HoodPaul/amiga-72pin-fpm-simm/README.md

# Amiga 72-pin FPM SIMM

A common PCB for **4 MB single-sided** and **8 MB double-sided** 5 V FPM SIMMs, developed for Amiga 4000 motherboard memory configurations. Current revision: **A7**.

The project began with a wish to make RAM that visually matches Re-Amiga systems: **black PCB, white silkscreen and gold contacts and exposed pads**. It is a collaboration between **Paul of UK Computing Limited**, **Jon of JMC Electronics** and **AI assistance through Codex**.

**FIRST SUCCESSFUL HARDWARE TEST: 7 November 2026.** Five custom Rev A7 SIMMs installed in an Amiga 4000D were recognised by Kickstart Memory Scan as **18.00 MB total (2.00 MB Chip RAM + 16.00 MB Fast RAM)**. The Chip RAM socket contained one physically **8 MB double-sided** module, recognised as **2 MB Chip RAM**; the four Fast RAM sockets contained four **4 MB front-only** modules. Paul reports the machine alive and working. This establishes initial detection and operation, not a completed extended memory, refresh, retention or graphics/DMA diagnostic. See the [first hardware test report](docs/2026-11-07-FIRST-A4000D-HARDWARE-TEST.md).

**Previous manufacturing milestone, 24 October 2026:** All 15 JLCPCB PCBs were reported manufactured and in transit. Five have since been assembled and demonstrated in the host. Exact receipt date, full shipment count and finished-board measurements have not been recorded. See the [manufacturing record](docs/FABRICATION-OPTIONS.md) and [production-file review](docs/JLCPCB-PRODUCTION-REVIEW.md).

For another engineer or AI picking up the project, start with [AGENTS.md](AGENTS.md), the [current AI handover](docs/AI-HANDOVER.md) and the [documentation index](docs/README.md).

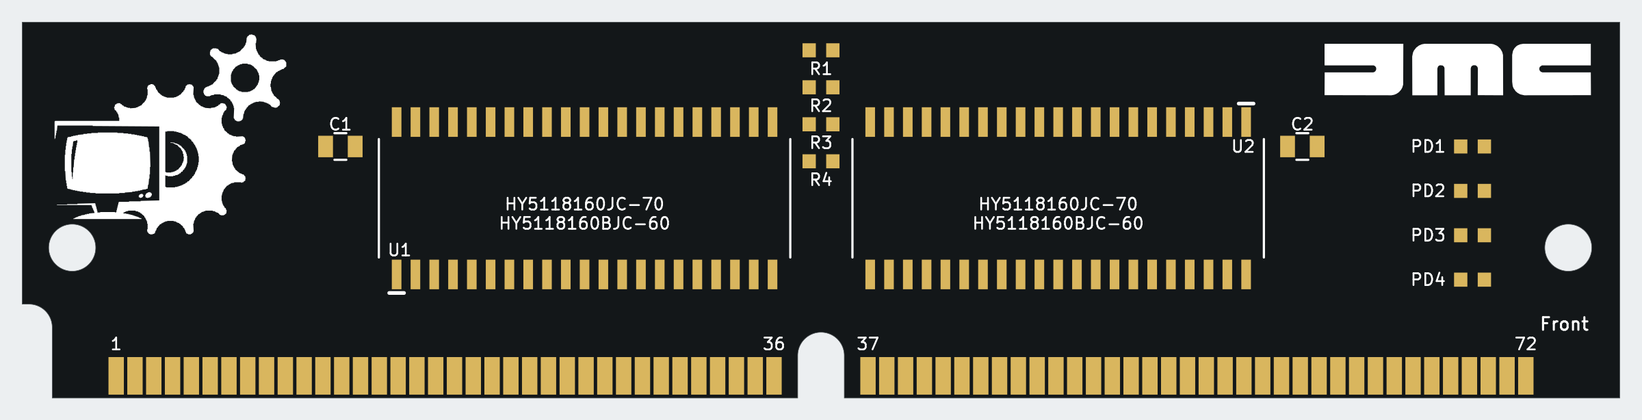
[picture p1: previews/appearance-front.png]
Front appearance

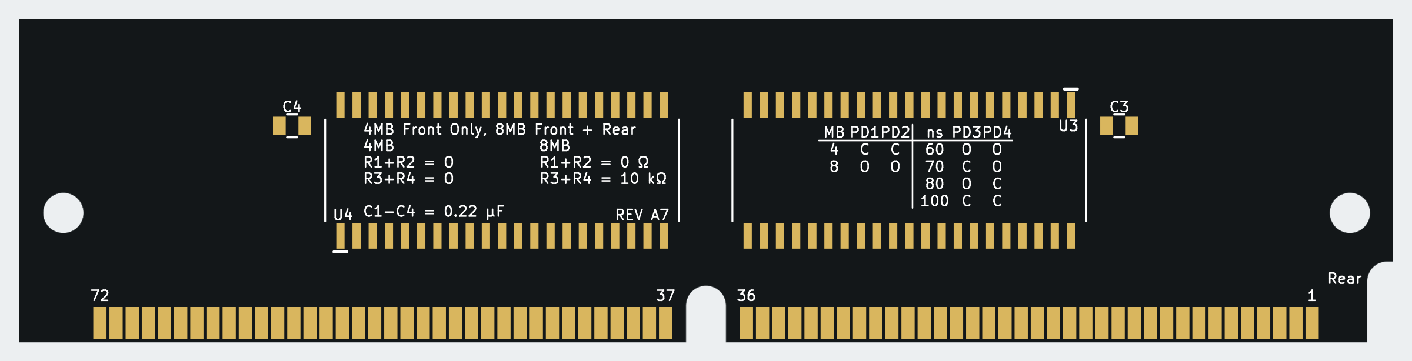
[picture p2: previews/appearance-rear.png]
Rear appearance


These are unpopulated CAD appearance previews: black solder mask, white silkscreen and gold exposed pads. Actual colours and contact plating are fabrication choices.

## PCB and files

Open [HY8M-SIMM.kicad_pro](HY8M-SIMM.kicad_pro) with **KiCad 10.0 or newer**. Project-local symbols and footprints are included.

| Property | Current design |
|---|---|
| Connector | 72-pin SIMM, 32-bit non-parity |
| Outline | 107.95 × 25.4 mm |
| Finished thickness | 1.2 mm ordered; measure finished boards and verify socket fit |
| Copper layers | **Four** |
| F.Cu | Front signals and pads |
| In1.Cu | GND plane |
| In2.Cu | Signals and +5 V copper fill |
| B.Cu | Rear signals and pads |
| Minimum signal track / nominal clearance | 0.20 / 0.20 mm |
| Through vias | 0.60 mm copper diameter / 0.30 mm drill |

In2.Cu is a mixed signal/supply layer. The design does not have separate GND and power planes on this four-layer PCB.

## 70 ns assembly options

Both builds use **HY5118160JC-70** DRAMs and the same PCB. DNP means do not populate.

| Build | DRAM population | Capacitors fitted | R1/R2 | R3/R4 | PD links fitted |
|---|---|---|---|---|---|
| [4 MB / 70 ns](variants/4MB-70ns/BOM.csv) | U1/U2, front only | C1/C2 | DNP | DNP | PD1, PD2, PD3 |
| [8 MB / 70 ns](variants/8MB-70ns/BOM.csv) | U1–U4, both faces | C1–C4 | 0 Ω each | 10 kΩ each | PD3 |

Capacitors are **220 nF (0.22 µF), 0805, X7R, 16 V or higher**. Use new capacitors. Links and pull-ups use 0603 pads. PD4 remains open in both builds.

Separate [60 ns variants](assembly-options.csv) are retained for the verified **HY5118160BJC-60** part. Use the chosen variant's BOM and DNP-marked schematic. Fitting different PD links cannot make a 70 ns chip operate as a 60 ns part.

A true 4 MB single-sided build omits U3/U4, C3/C4 and R1–R4. Disabling the rear rank of a physically double-sided board does not make it a single-sided module for socket clearance.

## Intended Amiga configurations

| Purpose | Intended population |
|---|---|
| 2 MB Chip RAM | One fully populated 8 MB module; intended to use 2 MB and leave 6 MB unaddressed |
| 16 MB Fast RAM | Two 8 MB modules in Fast slots 1 and 3 |
| 16 MB Fast RAM | Four front-only 4 MB modules in Fast slots 1–4 |

Fast-slot numbering excludes the separate Chip RAM socket. **The 8 MB physical Chip module used as 2 MB Chip RAM and four 4 MB Fast modules have now been recognised together on an A4000D (7 November 2026)**. The alternative two-8 MB Fast RAM configuration remains untested. The Chip RAM socket does not gain 8 MB of addressable Chip RAM. See [hardware test evidence](docs/2026-11-07-FIRST-A4000D-HARDWARE-TEST.md) and [compatibility research](docs/compatibility-research.md).

## Donor chips

The Hyundai HY5118160 devices were chosen for their relatively low SOJ package profile and the availability of suitable donor SIMMs on online marketplaces during project planning. This made them a practical starting point for the matching modules while keeping one chip family across the 4 MB and 8 MB builds.

Obtain readable photographs of **every fitted chip on both faces** before buying a donor. The specified 70 ns device is **HY5118160JC-70**: 5 V, 1M×16, FPM, 42-pin 400 mil SOJ, 1K refresh. The separately verified 60 ns alternative is **HY5118160BJC-60**.

An “8 MB / 2M×32 / 72-pin” listing or bare PCB number does not identify its chips. **HY5118164 is EDO**, and **HY5116160B has a different refresh organisation**; neither is the specified donor. Confirm the complete marking and datasheet rather than relying on similar part numbers.

### Most likely alternative DRAMs (not yet tested)

The **LG/GoldStar GM71C18160CJ-7 (70 ns)**, **GM71C18160CJ-6 (60 ns)**, **Samsung KM416C1200AJ-7 (70 ns)** and **KM416C1200AJ-6 (60 ns)** are promising **5 V, 1M × 16, FPM, 1K-refresh, 42-pin SOJ** candidates. **All four remain untested on Rev A7**, with no proven donor-board or Amiga hardware result. Confirm the exact part's pinout, package, refresh and timing before using it. See the [LG/Samsung alternative comparison and source links](docs/compatibility-research.md#high-confidence-lggoldstar-and-samsung-alternatives-untested-9-november-2026).

Test the intact donor before desoldering and record orientation/pin 1. One healthy four-chip donor can supply one 8 MB board or two 4 MB boards, assuming all devices survive removal. This project does not certify donor authenticity, seller stock or recovered-chip health.

## Prototype fabrication and remaining checks

- **Current order:** four layers, 1.2 mm nominal, 1 oz copper on all layers, black mask, white silkscreen, **ENIG 2 microinch**, ink-plugged vias, **no bevel**, deburring, no edge plating and no manufacturer mark. See the [ordering settings and screenshots](docs/FABRICATION-OPTIONS.md).
- **Contacts:** the native pad setback is **0.2286 mm**; CAM copper compensation leaves approximately **0.221 mm**. The original 144 findings against the generic 0.50 mm edge rule remain documented. The reviewed CAM preserves all contacts and functional connections; this is specific to this prototype package, not blanket approval for other manufacturers or bevel processes.
- **Finish and fit:** the selected ENIG prototype finish differs from the earlier selective hard-gold proposal. Hard gold offers better wear resistance for repeated insertion. Measure the finished connector thickness and inspect edge quality, SOJ fit and socket/case clearance before use. Substantial hand bevelling could cut into the plated contacts.

The retaining holes are closed circular Edge.Cuts profiles in the source; JLCPCB converted these to **3.18 mm finished non-plated holes** with compensated 3.25 mm tools. Use the [four-layer file map](docs/layer-file-map.txt) and read [fabrication notes](fabrication-review/READ-BEFORE-ORDERING.txt). The common paste layers include all footprints; assembly/stencil use must follow the chosen BOM.

## Checks and limitations

The saved design has **864 track segments, 195 vias and zero unconnected items**. The [exact copper comparison](docs/copper-comparison.txt) confirms unchanged routing, pads, component placements, outline and filled copper between A3–A6, the user-edited PCB and A7. The independent mapping review passes 321 assertions.

**144 contact-edge errors and 46 schematic-parity warnings remain documented.** Existing project settings ignore seven check types; no ERC report is included. Read [validation.txt](docs/validation.txt) and the [native DRC report](docs/drc-routed.json) for the scope and remaining findings. CAD checks do not establish timing, refresh, signal integrity or operation in an Amiga.

Run the portable preservation audit from the repository root:

```sh
python3 source/compare_copper.py
```

The current silkscreen preserves the manually edited layout, with UK Computing artwork on the front left and JMC on the front right. Rear assembly notes and PD tables sit beneath the rear chip bodies. Historical generator scripts can overwrite custom artwork; use the [development workflow](source/WORKFLOW.md).

## Project contents

| Path | Purpose |
|---|---|
| [BOM.csv](BOM.csv), [assembly-options.csv](assembly-options.csv) | Population comparison |
| [variants/](variants/) | Four assembly BOMs and DNP-marked schematics |
| [previews/](previews/) | Native layer plots, schematic and appearance views |
| [fabrication-review/](fabrication-review/) | Draft Gerbers, drills and fabrication notes |
| [docs/](docs/) | Pin map, research and validation reports |
| [source/](source/) | Artwork baseline, reference PCB and development/verification tools |
| [Assembly guide](docs/ASSEMBLY.md) | 70 ns parts, fitting and system quantities |
| [Component ordering](docs/COMPONENT-ORDERING.md) | DigiKey parts and quantities for either ten single-sided or ten double-sided modules, with spares |
| [Fabrication options](docs/FABRICATION-OPTIONS.md) | Current JLCPCB order and historical PCBWay quotation |
| [PCB ordering screenshots](docs/FABRICATION-OPTIONS.md#jlcpcb-ordering-screenshots) | JLCPCB settings, four-layer sequence and earlier PCBWay reminders |
| [JLCPCB production review](docs/JLCPCB-PRODUCTION-REVIEW.md) | Original-to-CAM comparison, compensated drills and confirmation action |
| [Project history](docs/PROJECT-HISTORY.md) | A1–A7 development record |
| [NOTICE.md](NOTICE.md) | Template attribution and supplied artwork |

## Attribution

Project collaboration: **Paul, UK Computing Limited; Jon, JMC Electronics; and AI assistance through Codex**. The collaborators ask that the UK Computing and JMC artwork remains in its existing positions on shared versions and manufactured boards derived from this design, with the project and template credits retained. See [attribution and supplied artwork](NOTICE.md).

The mechanical starting point is [wiretap-retro/72-pin-SIMM-KiCAD-Template](https://github.com/wiretap-retro/72-pin-SIMM-KiCAD-Template). Its original [template README](source/template-README.md) and [PCB template](source/template.kicad_pcb) are retained. Circuit/package facts come from Hyundai documentation; host behaviour and PD codes are sourced in [compatibility research](docs/compatibility-research.md).

This project is not a measured clone of PCB P1004B746400 / B7464 Rev.A.
