HoodPaul/amiga-72pin-fpm-simm/docs/README.md

# Project documentation index

Start with [AI instructions](../AGENTS.md), the [current handover](AI-HANDOVER.md)
and the [project overview](../README.md). Existing detailed records remain the
authoritative homes for assembly, fabrication and compatibility.

| Subject | Authoritative home |
| --- | --- |
| AI continuation/current work | [AI-HANDOVER.md](AI-HANDOVER.md) |
| Design structure and invariants | [ARCHITECTURE.md](ARCHITECTURE.md) |
| Development setup | [DEVELOPMENT.md](DEVELOPMENT.md) |
| CAD/script preservation procedure | [source/WORKFLOW.md](../source/WORKFLOW.md) |
| Checks and evidence limits | [TESTING.md](TESTING.md), [saved validation](validation.txt) |
| Physical test evidence | [HARDWARE-TEST-LOG.md](HARDWARE-TEST-LOG.md) |
| Assembly instructions | [ASSEMBLY.md](ASSEMBLY.md) |
| Exact fitting | [BOM.csv](../BOM.csv), [assembly-options.csv](../assembly-options.csv), selected [variant](../variants/) |
| Component ordering | [COMPONENT-ORDERING.md](COMPONENT-ORDERING.md) |
| Current order and shipping history | [FABRICATION-OPTIONS.md](FABRICATION-OPTIONS.md), [PROJECT-HISTORY.md](PROJECT-HISTORY.md) |
| Specific manufacturer CAM review | [JLCPCB-PRODUCTION-REVIEW.md](JLCPCB-PRODUCTION-REVIEW.md) |
| Export layer order and original notes | [layer map](layer-file-map.txt), [fabrication notes](../fabrication-review/READ-BEFORE-ORDERING.txt) |
| Host wiring, part compatibility and sources | [compatibility-research.md](compatibility-research.md) |
| Changes and collaboration | [CHANGELOG.md](../CHANGELOG.md), [CONTRIBUTING.md](../CONTRIBUTING.md) |
| Important decisions | [decisions](decisions/README.md) |
| Attribution, artwork and licensing position | [NOTICE.md](../NOTICE.md) |

## Maintenance

Update each subject in its authoritative document and link from summaries.
Preserve dated reports; new measurements need their own provenance. A status
update does not require regenerating CAD or fabrication exports. Mark proposals,
owner reports, archived checks and measured outcomes explicitly.

This public repository must not contain private tracking links, order/account
identifiers, addresses or credentials. No software production server, API
subscription, website deployment or application database belongs to this project.
