HoodPaul/amiga-72pin-fpm-simm/variants/4MB-60ns/README.md

# 4MB-60ns assembly

Use the common routed PCB at `../../HY8M-SIMM.kicad_pcb`.
This schematic marks the unfitted components with KiCad DNP flags.
Use this folder's BOM. There is no separate PCB geometry for this assembly.

Fit: C1, C2, PD1, PD2, U1, U2.

Leave unfitted: C3, C4, PD3, PD4, R1, R2, R3, R4, U3, U4.

The 4 MB build uses 2 HY5118160BJC-60 devices.
Physical fit, donor health, timing and A4000 operation remain untested.
