HoodPaul/amiga-72pin-fpm-simm/variants/8MB-70ns/README.md

# 8MB-70ns assembly

Use the common routed PCB at `../../HY8M-SIMM.kicad_pcb`.
This schematic marks the unfitted components with KiCad DNP flags.
Use this folder's BOM. There is no separate PCB geometry for this assembly.

Fit: C1, C2, C3, C4, PD3, R1, R2, R3, R4, U1, U2, U3, U4.

Leave unfitted: PD1, PD2, PD4.

The 8 MB build uses 4 HY5118160JC-70 devices.
Physical fit, donor health, timing and A4000 operation remain untested.
