HoodPaul/amiga-72pin-fpm-simm/previews/front.png

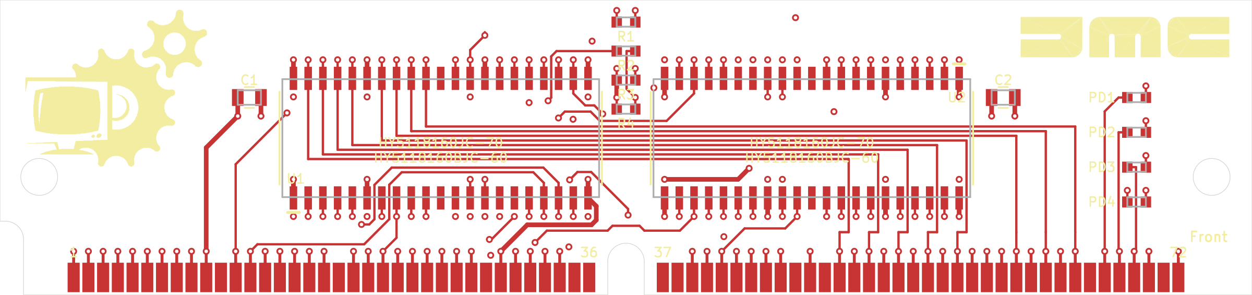
previews/front.png
