HoodPaul/amiga-72pin-fpm-simm/previews/ground-plane.png

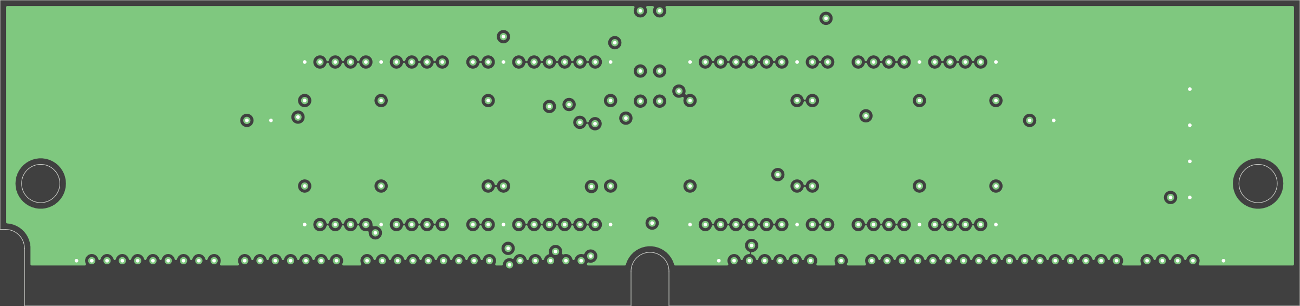
previews/ground-plane.png
