HoodPaul/amiga-72pin-fpm-simm/previews/HY8M-SIMM.png

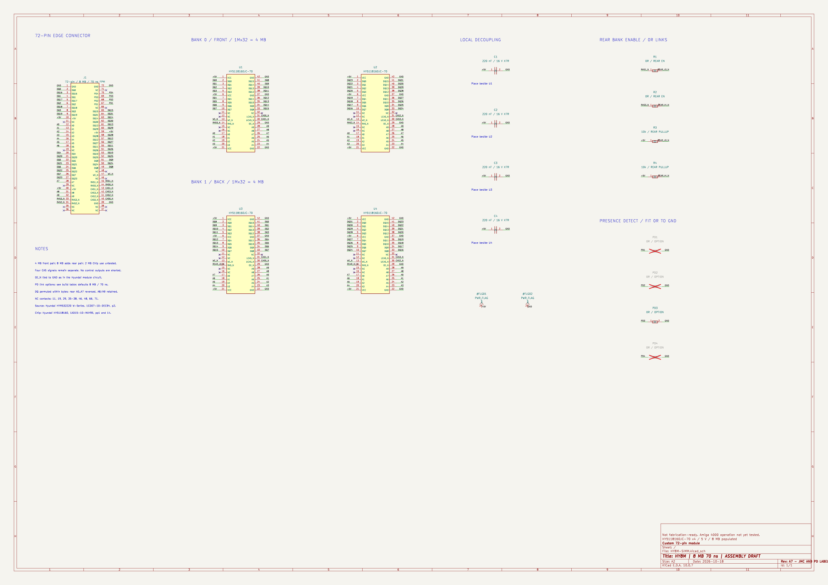
previews/HY8M-SIMM.png
