HoodPaul/amiga-72pin-fpm-simm/previews/inner-mixed.png

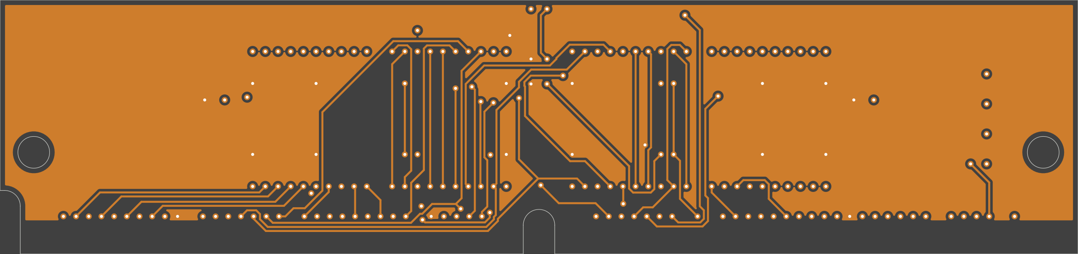
previews/inner-mixed.png
