HoodPaul/amiga-72pin-fpm-simm/previews/rear.png

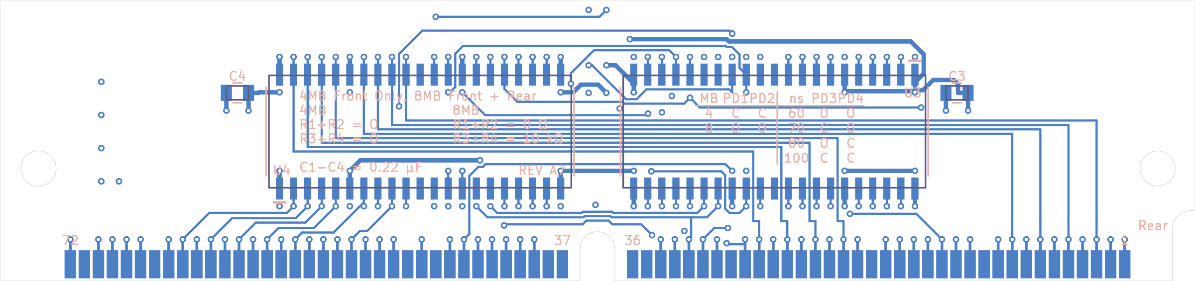
previews/rear.png
