HoodPaul/amiga-72pin-fpm-simm/previews/silk-front.png

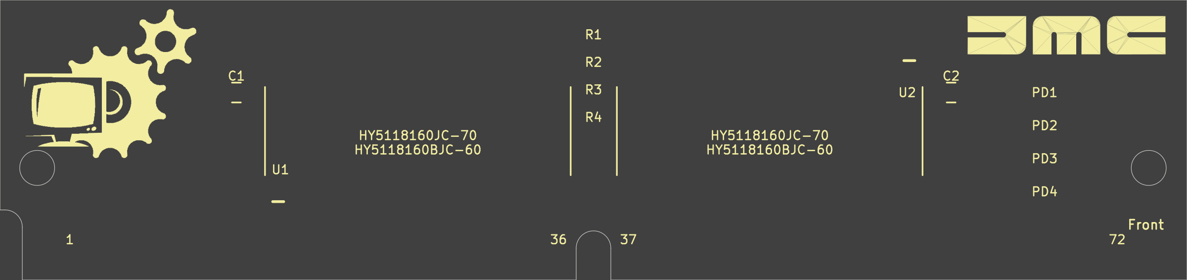
previews/silk-front.png
