HoodPaul/amiga-72pin-fpm-simm/previews/silk-rear.png

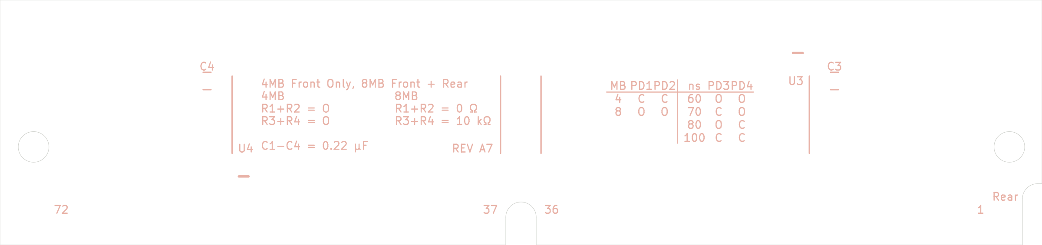
previews/silk-rear.png
