HoodPaul/amiga-72pin-fpm-simm/source/JMC-source.png

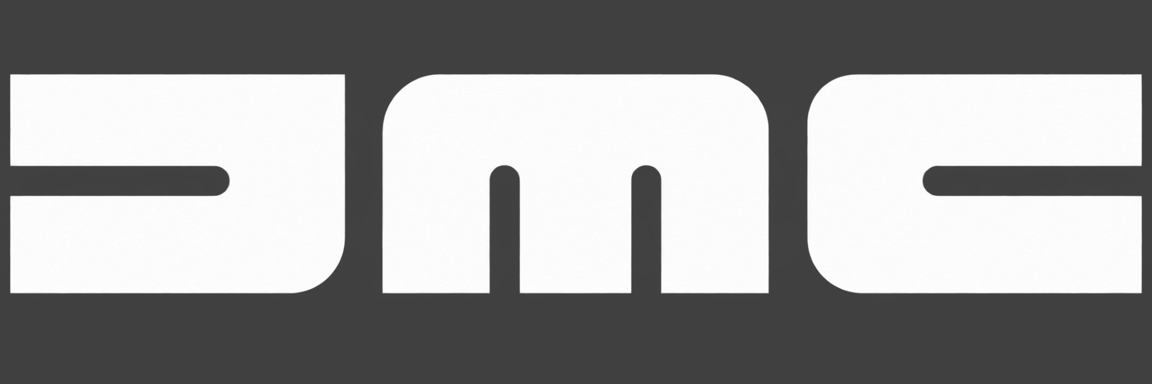
source/JMC-source.png
