HoodPaul/amiga-72pin-fpm-simm/docs/pin-net-map.csv

Reference | Pin | Signal | Net
J1 | 1 | GND | GND
J1 | 2 | DQ0 | DQ0
J1 | 3 | DQ16 | DQ16
J1 | 4 | DQ1 | DQ1
J1 | 5 | DQ17 | DQ17
J1 | 6 | DQ2 | DQ2
J1 | 7 | DQ18 | DQ18
J1 | 8 | DQ3 | DQ3
J1 | 9 | DQ19 | DQ19
J1 | 10 | +5V | +5V
J1 | 11 | NC | NC
J1 | 12 | A0 | A0
J1 | 13 | A1 | A1
J1 | 14 | A2 | A2
J1 | 15 | A3 | A3
J1 | 16 | A4 | A4
J1 | 17 | A5 | A5
J1 | 18 | A6 | A6
J1 | 19 | NC | NC
J1 | 20 | DQ4 | DQ4
J1 | 21 | DQ20 | DQ20
J1 | 22 | DQ5 | DQ5
J1 | 23 | DQ21 | DQ21
J1 | 24 | DQ6 | DQ6
J1 | 25 | DQ22 | DQ22
J1 | 26 | DQ7 | DQ7
J1 | 27 | DQ23 | DQ23
J1 | 28 | A7 | A7
J1 | 29 | NC | NC
J1 | 30 | +5V | +5V
J1 | 31 | A8 | A8
J1 | 32 | A9 | A9
J1 | 33 | RAS3_N | RAS3_N
J1 | 34 | RAS2_N | RAS2_N
J1 | 35 | NC | NC
J1 | 36 | NC | NC
J1 | 37 | NC | NC
J1 | 38 | NC | NC
J1 | 39 | GND | GND
J1 | 40 | CAS0_N | CAS0_N
J1 | 41 | CAS2_N | CAS2_N
J1 | 42 | CAS3_N | CAS3_N
J1 | 43 | CAS1_N | CAS1_N
J1 | 44 | RAS0_N | RAS0_N
J1 | 45 | RAS1_N | RAS1_N
J1 | 46 | NC | NC
J1 | 47 | WE_N | WE_N
J1 | 48 | NC | NC
J1 | 49 | DQ8 | DQ8
J1 | 50 | DQ24 | DQ24
J1 | 51 | DQ9 | DQ9
J1 | 52 | DQ25 | DQ25
J1 | 53 | DQ10 | DQ10
J1 | 54 | DQ26 | DQ26
J1 | 55 | DQ11 | DQ11
J1 | 56 | DQ27 | DQ27
J1 | 57 | DQ12 | DQ12
J1 | 58 | DQ28 | DQ28
J1 | 59 | +5V | +5V
J1 | 60 | DQ29 | DQ29
J1 | 61 | DQ13 | DQ13
J1 | 62 | DQ30 | DQ30
J1 | 63 | DQ14 | DQ14
J1 | 64 | DQ31 | DQ31
J1 | 65 | DQ15 | DQ15
J1 | 66 | NC | NC
J1 | 67 | PD1 | PD1
J1 | 68 | PD2 | PD2
J1 | 69 | PD3 | PD3
J1 | 70 | PD4 | PD4
J1 | 71 | NC | NC
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
R1 | 2 | 2 | REAR_LO_N
R2 | 1 | 1 | RAS3_N
R2 | 2 | 2 | REAR_HI_N
R3 | 1 | 1 | +5V
R3 | 2 | 2 | REAR_LO_N
R4 | 1 | 1 | +5V
R4 | 2 | 2 | REAR_HI_N
PD1 | 1 | 1 | PD1
PD1 | 2 | 2 | GND
PD2 | 1 | 1 | PD2
PD2 | 2 | 2 | GND
PD3 | 1 | 1 | PD3
PD3 | 2 | 2 | GND
PD4 | 1 | 1 | PD4
PD4 | 2 | 2 | GND
