HoodPaul/amiga-72pin-fpm-simm/docs/DIGIKEY-ORDER-10-MODULES.txt

1276-1093-1-ND	50
311-0.0GRCT-ND	50
P10.0KHCT-ND	50
