HoodPaul/amiga-72pin-fpm-simm/docs/hardware-tests/2026-11-07/README.md

# 7 November 2026: First successful Rev A7 A4000D test photographs

This folder is reserved for the two original photographs provided by Paul on 7 November 2026. The full-resolution image files are **not yet uploaded to GitHub**.

Expected files:

- `a4000d-reva7-installed-simms.png`: Five custom Rev A7 SIMMs fitted to an Amiga 4000D motherboard.
- `a4000d-reva7-memory-scan-18mb.png`: Kickstart Memory Scan detecting 18.00 MB total, comprising 2.00 MB Chip RAM and 16.00 MB Fast RAM.

The [dated test report](../../2026-11-07-FIRST-A4000D-HARDWARE-TEST.md) records the test result, scope and outstanding diagnostics.

Once both images are uploaded, they can be embedded in this folder's README and linked from the test report. Do not state that the photographs are available until the files exist in this directory.
