HoodPaul/amiga-72pin-fpm-simm/docs/hardware-tests/2026-11-07/a4000d-reva7-memory-scan-18mb.png

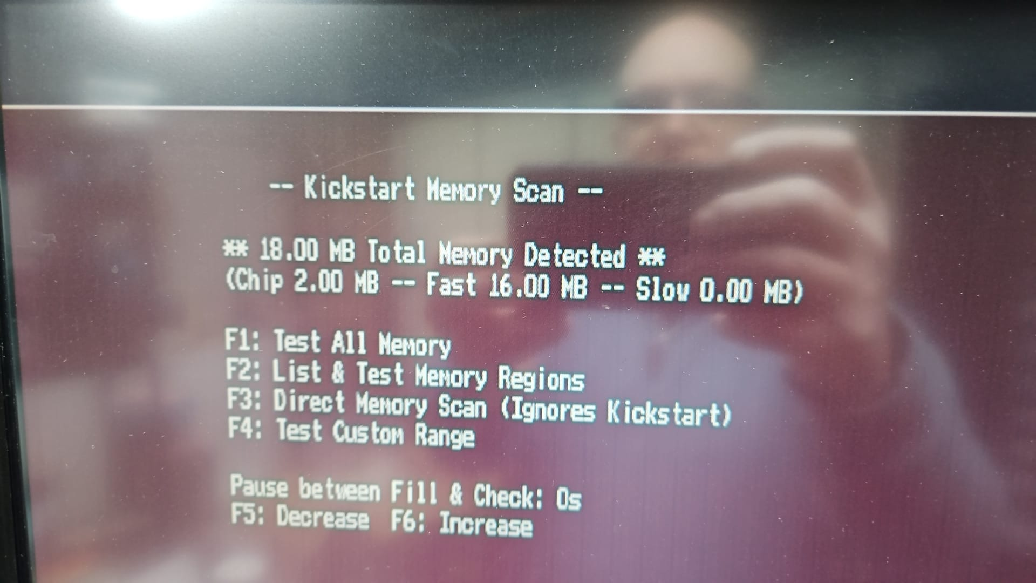
docs/hardware-tests/2026-11-07/a4000d-reva7-memory-scan-18mb.png
