HoodPaul/amiga-72pin-fpm-simm/CHANGELOG.md

# Changelog

Selected project milestones. Source revisions, fabrication progress and hardware
validation are separate; see [project history](docs/PROJECT-HISTORY.md).

## 9 November 2026: alternative DRAM sourcing research

- Add **LG/GoldStar GM71C18160CJ-6/-7** and **Samsung KM416C1200AJ-6/-7** as **high-confidence, untested candidate** replacements for future Rev A7 builds.
- Record FPM, 5 V, 1M × 16, 1K refresh and SOJ package requirements, source references, excluded similarly named parts and a physical validation plan.
- No alternative chips have been tested in the A4000D. The proven Hyundai assembly, KiCad design, footprints, existing BOMs and manufacturing outputs are unchanged.

## Unreleased documentation change, 24 October 2026

- Record Paul's report that PCB fabrication is complete and the 15 JLCPCB boards are in transit.
- Add shared AI instructions, Claude entry point, current handover, documentation index, design/development/testing guides, a blank hardware test log, contribution guidance and decision records.
- Correct the fabrication note's superseded confirmation status without changing the original exports.
- Native CAD, BOMs, libraries, Gerbers, drills and archived validation reports are unchanged.

## Recorded on 21 October 2026

- Owner-reported PCBs in manufacture and donor RAM in transit.

## A7 design history

A7 preserves the accepted four-layer routing and uploaded manual artwork while
adding JMC branding and aligning PD references. See the detailed
[revision history](docs/PROJECT-HISTORY.md) and [production CAM review](docs/JLCPCB-PRODUCTION-REVIEW.md).
No assembled-module hardware validation is recorded at this checkpoint.
