HoodPaul/amiga-72pin-fpm-simm/(list of files, drawings)

Other design files:
routing/three-prepared.dsn
