HoodPaul/amiga-72pin-fpm-simm/HY8M-SIMM.kicad_pcb

## KiCad design HY8M-SIMM.kicad_pcb (2026-10-19)

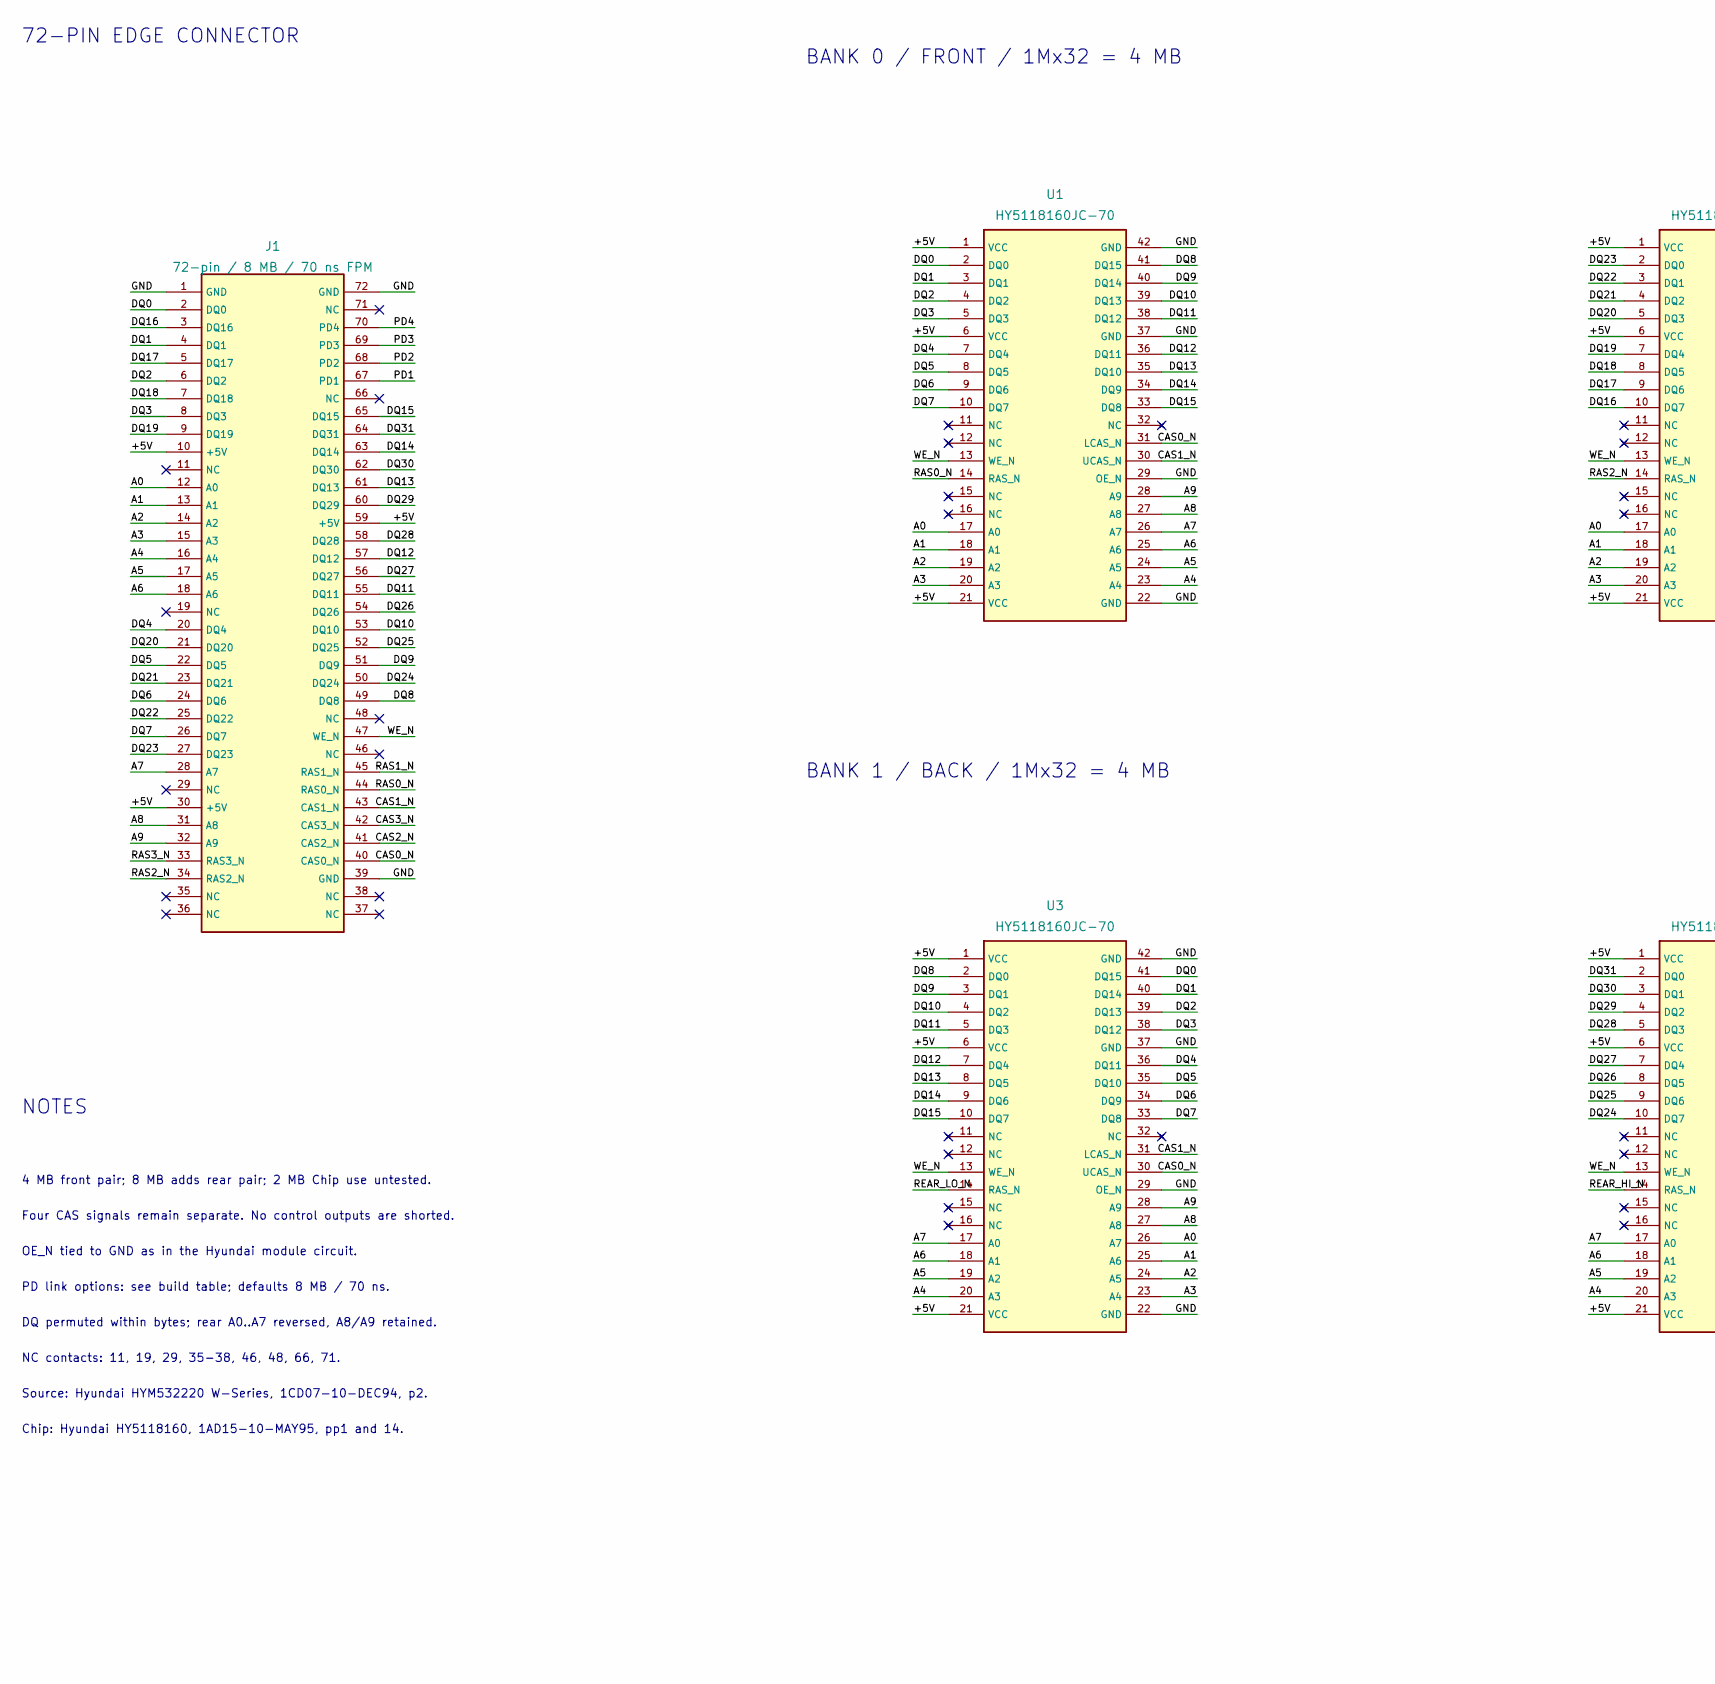
[picture p20: schematic HY8M-SIMM.kicad_sch, HY8M | 8 MB 70 ns | ASSEMBLY DRAFT, part in row 1, column 1]

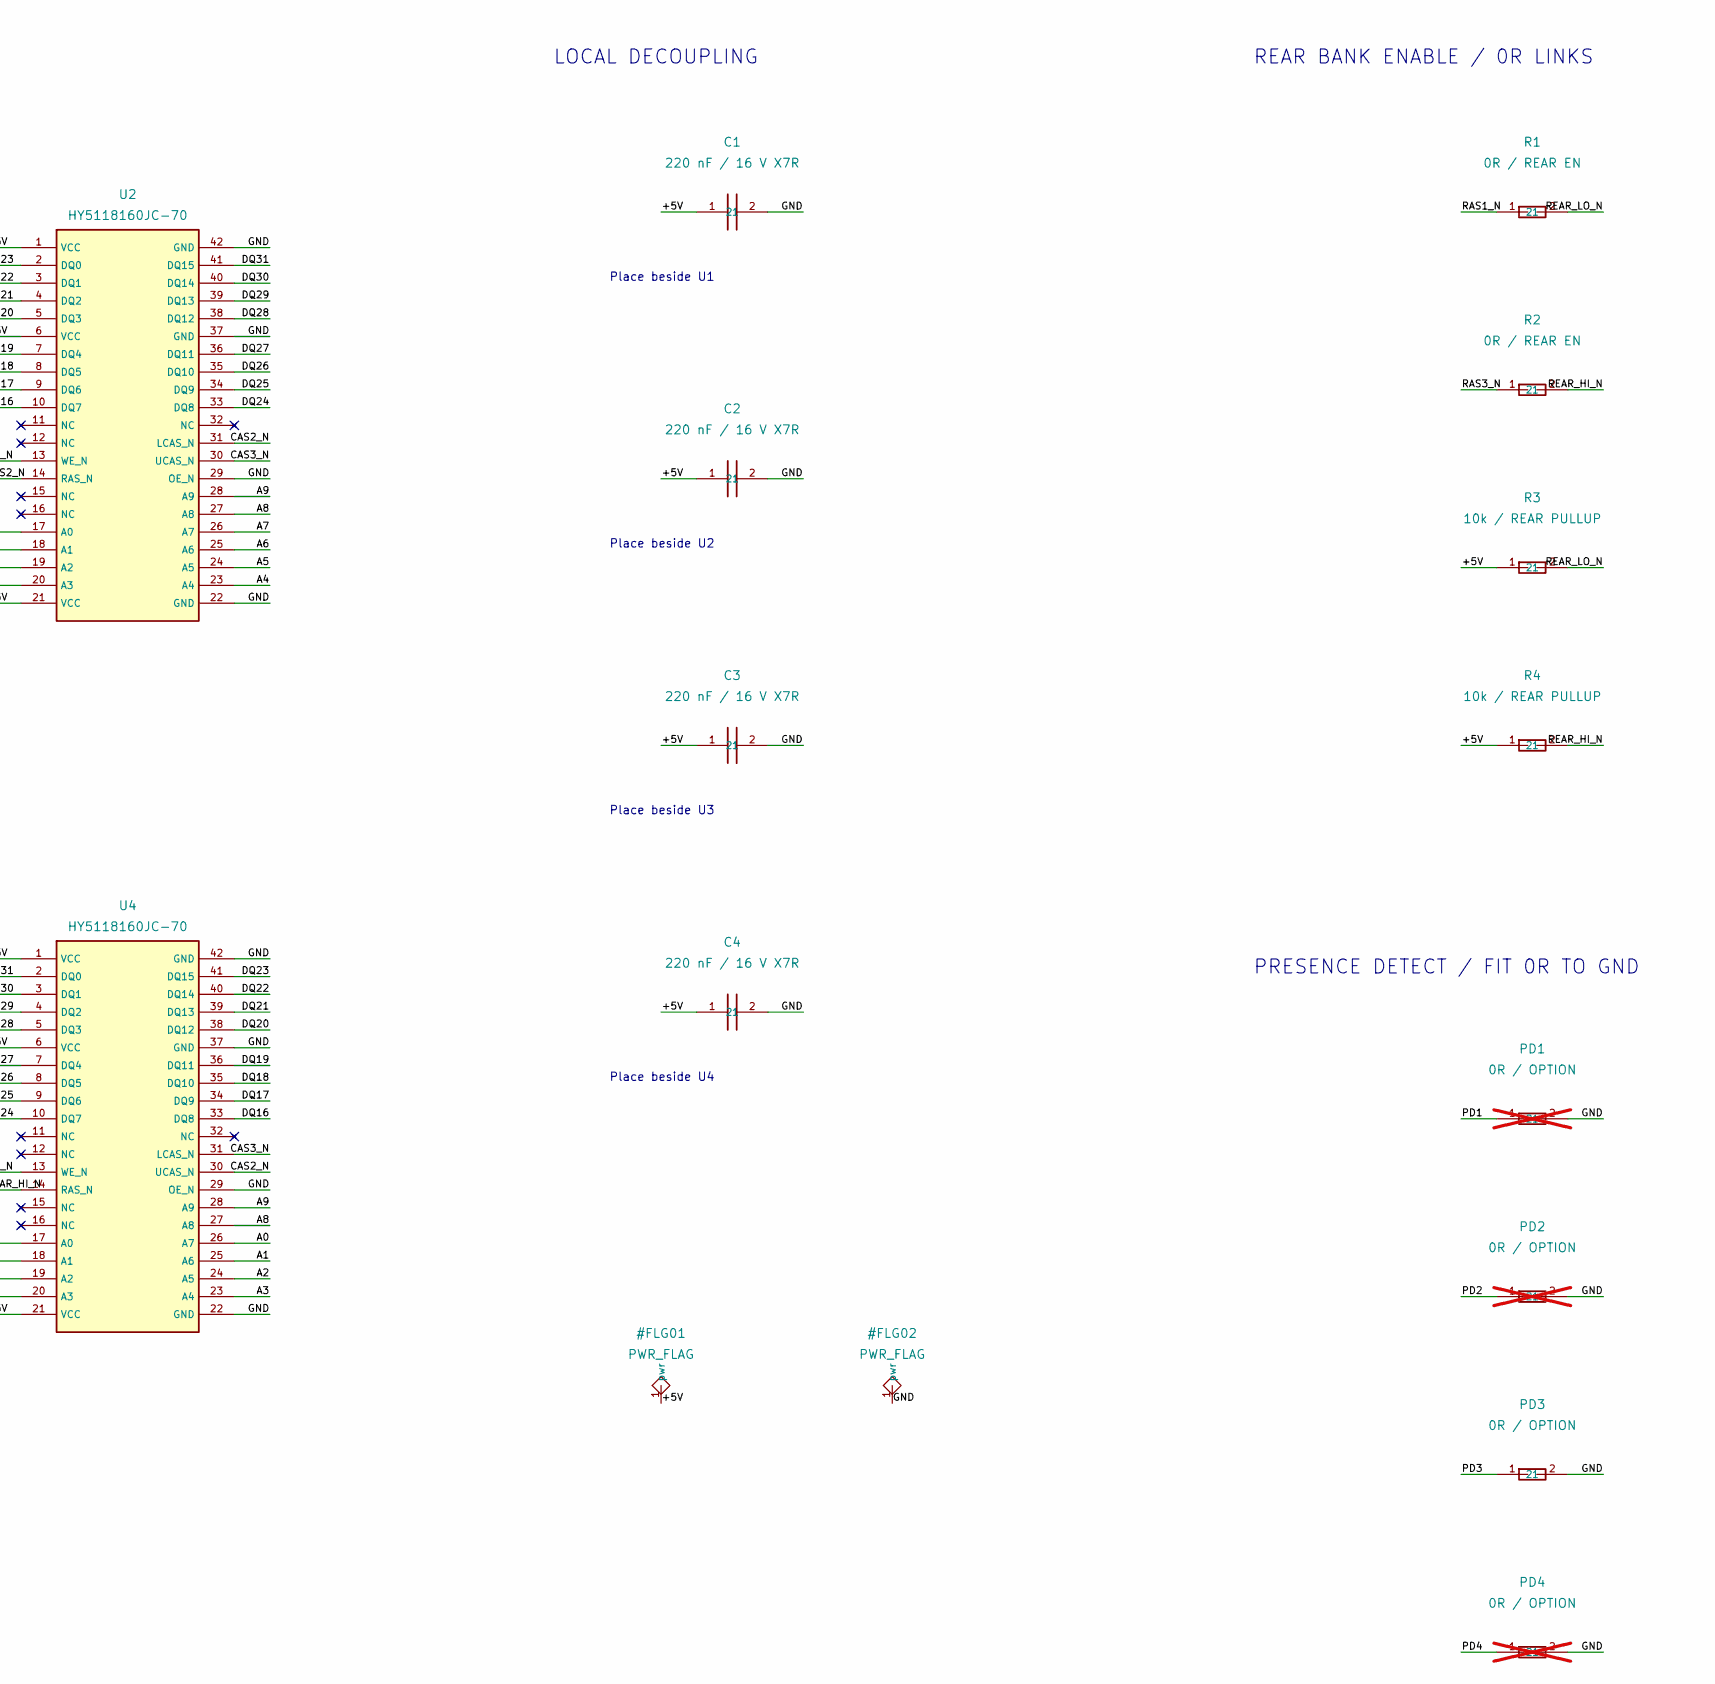
[picture p21: schematic HY8M-SIMM.kicad_sch, HY8M | 8 MB 70 ns | ASSEMBLY DRAFT, part in row 1, column 2]

Parts:
C1, C2, C3, C4: 220 nF / 16 V X7R; C_0805
J1: 72-pin / 8 MB / 70 ns FPM; SIMM72
PD1, PD2, PD4: 0R / OPTION; R_0603; not fitted
PD3: 0R / OPTION; R_0603
R1, R2: 0R / REAR EN; R_0603
R3, R4: 10k / REAR PULLUP; R_0603
U1, U2, U3, U4: HY5118160JC-70; SOJ42_400mil

Connections:
/+5V: C1.1, C2.1, C3.1, C4.1, J1.10 (+5V), J1.30 (+5V), J1.59 (+5V), R3.1, R4.1, U1.1 (VCC), U1.6 (VCC), U1.21 (VCC), U2.1 (VCC), U2.6 (VCC), U2.21 (VCC), U3.1 (VCC), U3.6 (VCC), U3.21 (VCC), U4.1 (VCC), U4.6 (VCC), U4.21 (VCC)
/A0: J1.12 (A0), U1.17 (A0), U2.17 (A0), U3.26 (A7), U4.26 (A7)
/A1: J1.13 (A1), U1.18 (A1), U2.18 (A1), U3.25 (A6), U4.25 (A6)
/A2: J1.14 (A2), U1.19 (A2), U2.19 (A2), U3.24 (A5), U4.24 (A5)
/A3: J1.15 (A3), U1.20 (A3), U2.20 (A3), U3.23 (A4), U4.23 (A4)
/A4: J1.16 (A4), U1.23 (A4), U2.23 (A4), U3.20 (A3), U4.20 (A3)
/A5: J1.17 (A5), U1.24 (A5), U2.24 (A5), U3.19 (A2), U4.19 (A2)
/A6: J1.18 (A6), U1.25 (A6), U2.25 (A6), U3.18 (A1), U4.18 (A1)
/A7: J1.28 (A7), U1.26 (A7), U2.26 (A7), U3.17 (A0), U4.17 (A0)
/A8: J1.31 (A8), U1.27 (A8), U2.27 (A8), U3.27 (A8), U4.27 (A8)
/A9: J1.32 (A9), U1.28 (A9), U2.28 (A9), U3.28 (A9), U4.28 (A9)
/CAS0_N: J1.40 (CAS0_N), U1.31 (LCAS_N), U3.30 (UCAS_N)
/CAS1_N: J1.43 (CAS1_N), U1.30 (UCAS_N), U3.31 (LCAS_N)
/CAS2_N: J1.41 (CAS2_N), U2.31 (LCAS_N), U4.30 (UCAS_N)
/CAS3_N: J1.42 (CAS3_N), U2.30 (UCAS_N), U4.31 (LCAS_N)
/DQ0: J1.2 (DQ0), U1.2 (DQ0), U3.41 (DQ15)
/DQ1: J1.4 (DQ1), U1.3 (DQ1), U3.40 (DQ14)
/DQ2: J1.6 (DQ2), U1.4 (DQ2), U3.39 (DQ13)
/DQ3: J1.8 (DQ3), U1.5 (DQ3), U3.38 (DQ12)
/DQ4: J1.20 (DQ4), U1.7 (DQ4), U3.36 (DQ11)
/DQ5: J1.22 (DQ5), U1.8 (DQ5), U3.35 (DQ10)
/DQ6: J1.24 (DQ6), U1.9 (DQ6), U3.34 (DQ9)
/DQ7: J1.26 (DQ7), U1.10 (DQ7), U3.33 (DQ8)
/DQ8: J1.49 (DQ8), U1.41 (DQ15), U3.2 (DQ0)
/DQ9: J1.51 (DQ9), U1.40 (DQ14), U3.3 (DQ1)
/DQ10: J1.53 (DQ10), U1.39 (DQ13), U3.4 (DQ2)
/DQ11: J1.55 (DQ11), U1.38 (DQ12), U3.5 (DQ3)
/DQ12: J1.57 (DQ12), U1.36 (DQ11), U3.7 (DQ4)
/DQ13: J1.61 (DQ13), U1.35 (DQ10), U3.8 (DQ5)
/DQ14: J1.63 (DQ14), U1.34 (DQ9), U3.9 (DQ6)
/DQ15: J1.65 (DQ15), U1.33 (DQ8), U3.10 (DQ7)
/DQ16: J1.3 (DQ16), U2.10 (DQ7), U4.33 (DQ8)
/DQ17: J1.5 (DQ17), U2.9 (DQ6), U4.34 (DQ9)
/DQ18: J1.7 (DQ18), U2.8 (DQ5), U4.35 (DQ10)
/DQ19: J1.9 (DQ19), U2.7 (DQ4), U4.36 (DQ11)
/DQ20: J1.21 (DQ20), U2.5 (DQ3), U4.38 (DQ12)
/DQ21: J1.23 (DQ21), U2.4 (DQ2), U4.39 (DQ13)
/DQ22: J1.25 (DQ22), U2.3 (DQ1), U4.40 (DQ14)
/DQ23: J1.27 (DQ23), U2.2 (DQ0), U4.41 (DQ15)
/DQ24: J1.50 (DQ24), U2.33 (DQ8), U4.10 (DQ7)
/DQ25: J1.52 (DQ25), U2.34 (DQ9), U4.9 (DQ6)
/DQ26: J1.54 (DQ26), U2.35 (DQ10), U4.8 (DQ5)
/DQ27: J1.56 (DQ27), U2.36 (DQ11), U4.7 (DQ4)
/DQ28: J1.58 (DQ28), U2.38 (DQ12), U4.5 (DQ3)
/DQ29: J1.60 (DQ29), U2.39 (DQ13), U4.4 (DQ2)
/DQ30: J1.62 (DQ30), U2.40 (DQ14), U4.3 (DQ1)
/DQ31: J1.64 (DQ31), U2.41 (DQ15), U4.2 (DQ0)
/GND: C1.2, C2.2, C3.2, C4.2, J1.1 (GND), J1.39 (GND), J1.72 (GND), PD1.2, PD2.2, PD3.2, PD4.2, U1.22 (GND), U1.29 (OE_N), U1.37 (GND), U1.42 (GND), U2.22 (GND), U2.29 (OE_N), U2.37 (GND), U2.42 (GND), U3.22 (GND), U3.29 (OE_N), U3.37 (GND), U3.42 (GND), U4.22 (GND), U4.29 (OE_N), U4.37 (GND), U4.42 (GND)
/PD1: J1.67 (PD1), PD1.1
/PD2: J1.68 (PD2), PD2.1
/PD3: J1.69 (PD3), PD3.1
/PD4: J1.70 (PD4), PD4.1
/RAS0_N: J1.44 (RAS0_N), U1.14 (RAS_N)
/RAS1_N: J1.45 (RAS1_N), R1.1
/RAS2_N: J1.34 (RAS2_N), U2.14 (RAS_N)
/RAS3_N: J1.33 (RAS3_N), R2.1
/REAR_HI_N: R2.2, R4.2, U4.14 (RAS_N)
/REAR_LO_N: R1.2, R3.2, U3.14 (RAS_N)
/WE_N: J1.47 (WE_N), U1.13 (WE_N), U2.13 (WE_N), U3.13 (WE_N), U4.13 (WE_N)

Notes on the sheet:
72-PIN EDGE CONNECTOR
BANK 0 / FRONT / 1Mx32 = 4 MB
BANK 1 / BACK / 1Mx32 = 4 MB
LOCAL DECOUPLING
Place beside U1
Place beside U2
Place beside U3
Place beside U4
REAR BANK ENABLE / 0R LINKS
PRESENCE DETECT / FIT 0R TO GND
NOTES
4 MB front pair; 8 MB adds rear pair; 2 MB Chip use untested.
Four CAS signals remain separate. No control outputs are shorted.
OE_N tied to GND as in the Hyundai module circuit.
PD link options: see build table; defaults 8 MB / 70 ns.
DQ permuted within bytes; rear A0..A7 reversed, A8/A9 retained.
NC contacts: 11, 19, 29, 35-38, 46, 48, 66, 71.
Source: Hyundai HYM532220 W-Series, 1CD07-10-DEC94, p2.
Chip: Hyundai HY5118160, 1AD15-10-MAY95, pp1 and 14.

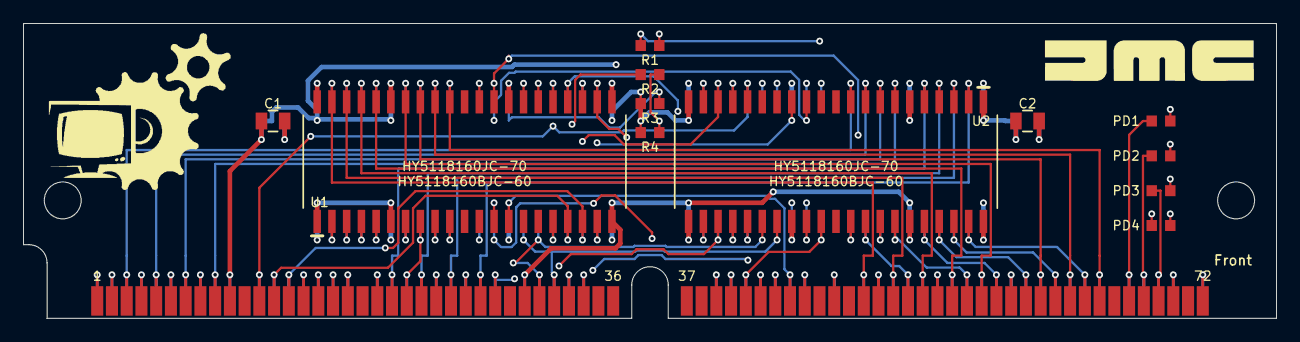
[picture p22: board HY8M-SIMM.kicad_pcb from above]

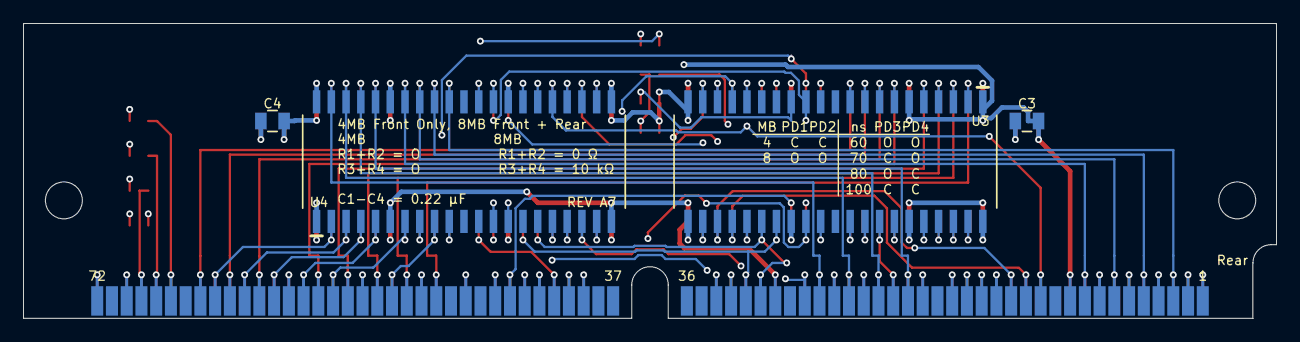
[picture p23: board HY8M-SIMM.kicad_pcb from below]

Board: 4 copper layers, 107.9 x 25.4 mm, 17 parts (4 on the bottom side), 59 nets.
