HoodPaul/amiga-72pin-fpm-simm/(commit log)

2026-10-19 Add A7 four-layer Amiga FPM SIMM project
    [BOM.csv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]
2026-10-19 Add PCBWay ordering screenshots and fabrication reminders
2026-10-19 Add ten-module DigiKey component ordering BOM and quantities
2026-10-20 Document JLCPCB prototype order and A7 production-file review
2026-10-21 Record 21 October status: donor RAM in transit and PCBs in manufacture
2026-10-24 Add AI handover and record completed PCB fabrication and transit (#1)
    Add shared AI instructions and hardware-project documentation. Record owner's 24 October 2026 fabrication-complete and in-transit update; preserve CAD, BOMs, exports and archived reports.
